ebastler/S21Evo/S21Evo_BST/S21Evo_BST.pdf

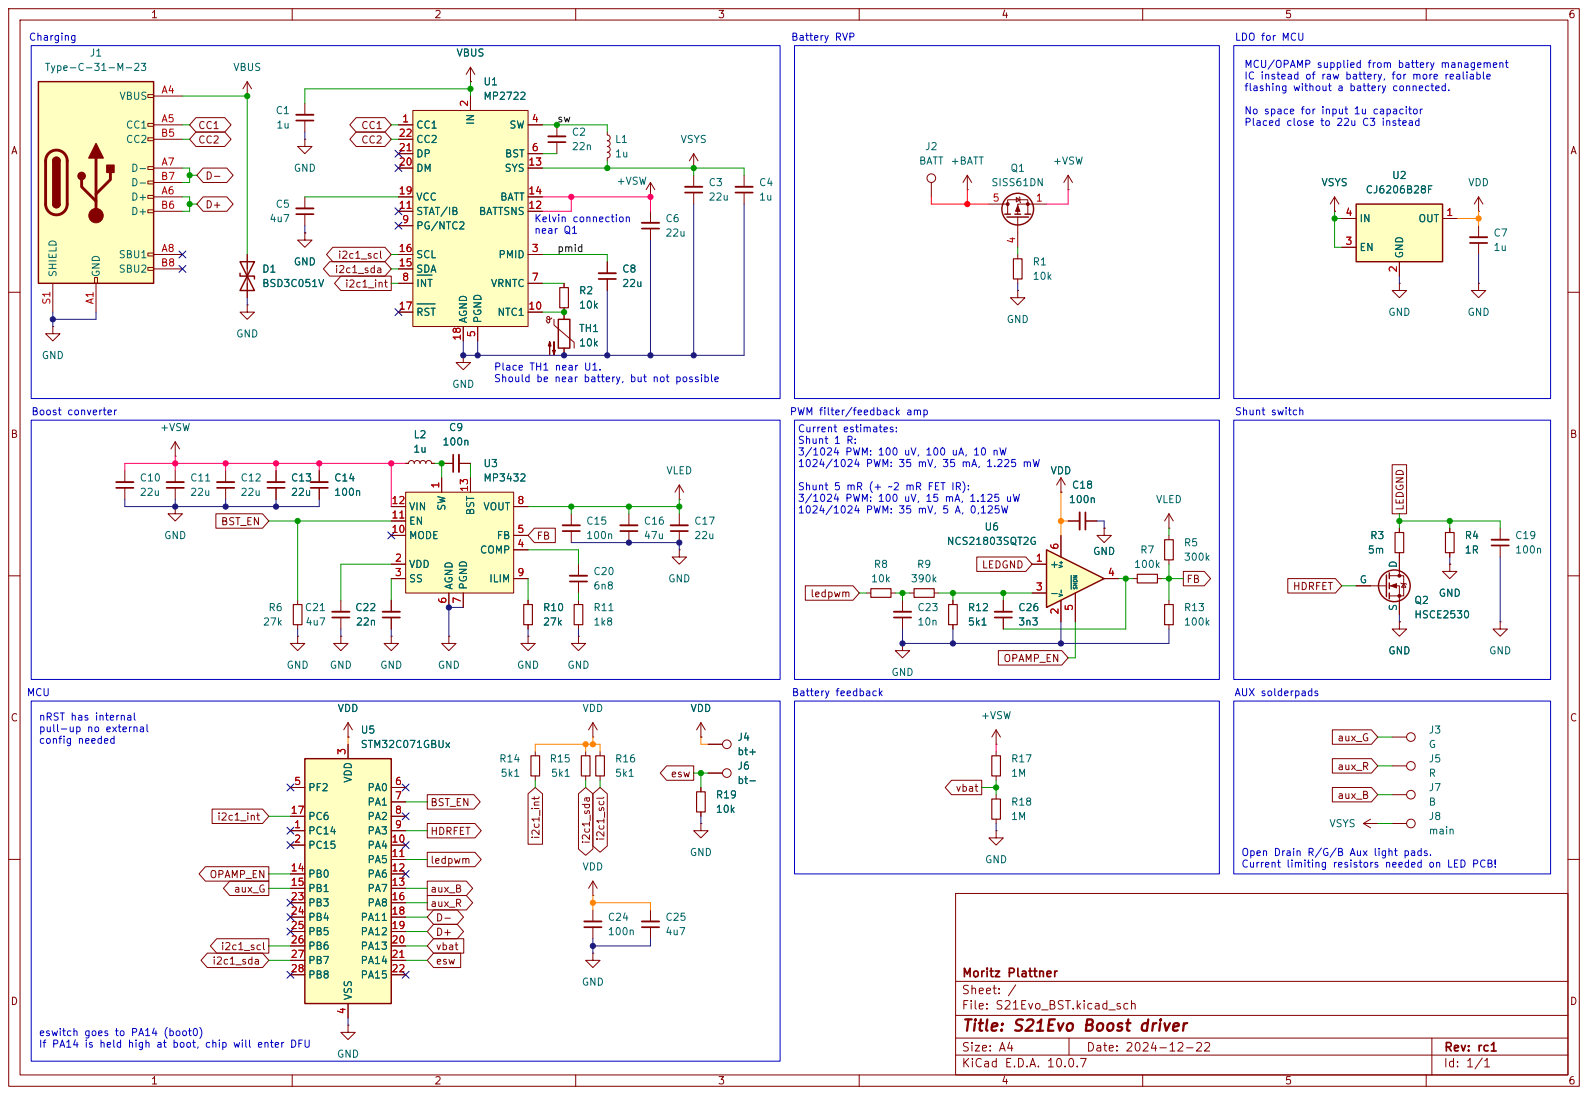
[picture p1: page 1]

LDO for MCU MCU

IC instead of raw battery, for more realiable
flashing without a battery connected. No space for input 1u capacitor Placed close to 22u C3 instead

1024/1024 PWM: 35 mV, 35 mA, 1.225 mW

Shunt 5 mR (+ ~2 mR FET IR):
3/1024 PWM: 100 uV, 15 mA, 1.125 uW
1024/1024 PWM: 35 mV, 5 A, 0,125W

eswitch goes to PA14 (boot0)
If PA14 is held high at boot, chip will enter DFU

Size: A4 | Rev: rc1
KiCad E.D.A. 10.0.7 | Id: 1/1
