ebastler/S21Evo/S21Evo_BST/S21Evo_BST.kicad_pcb

## KiCad design S21Evo_BST/S21Evo_BST.kicad_pcb (2026-10-29)

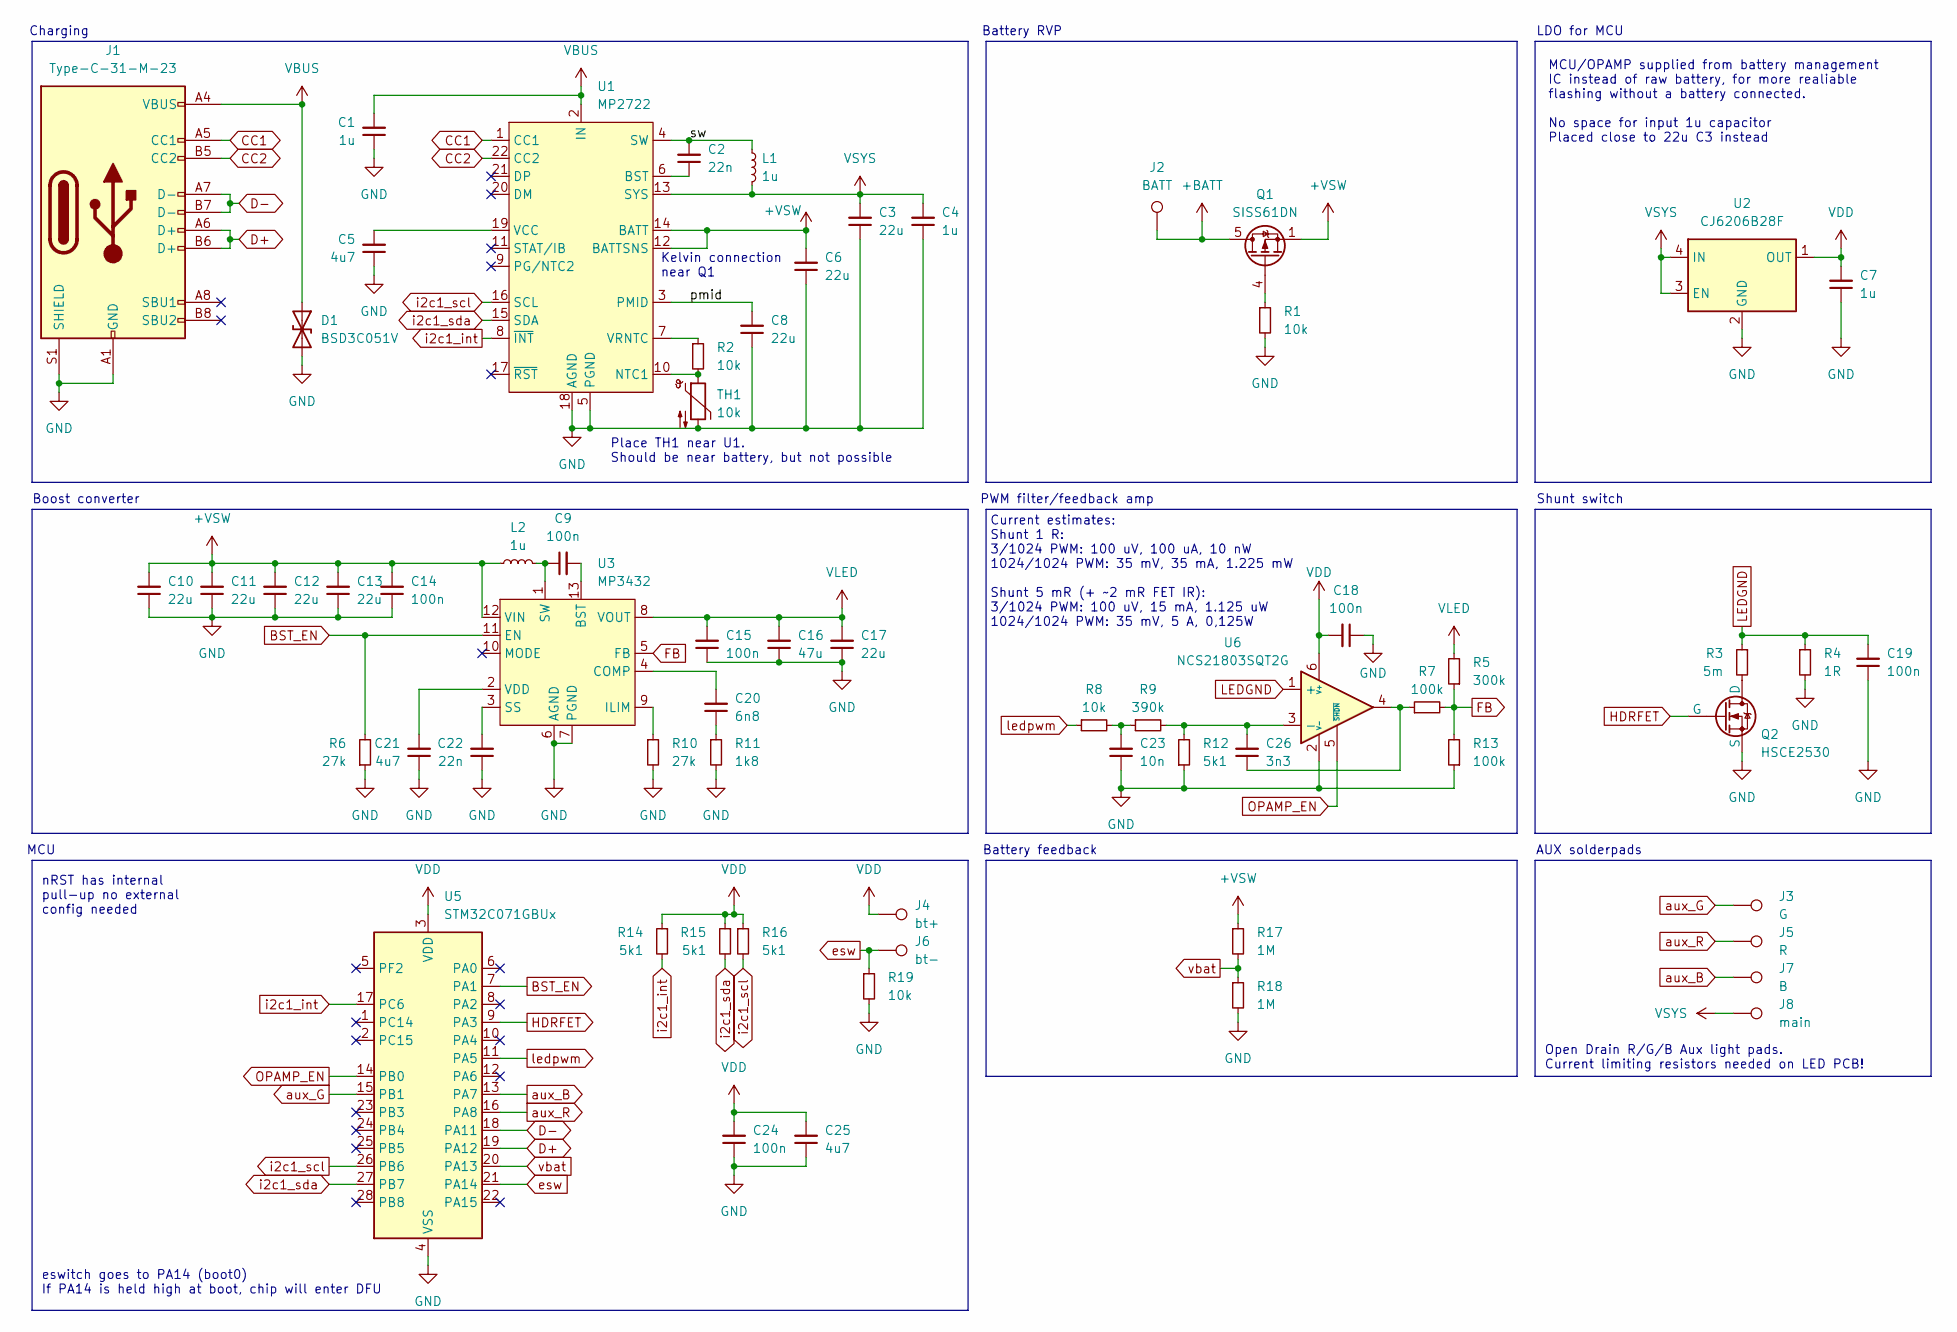
[picture p2: schematic S21Evo_BST.kicad_sch, S21Evo Boost driver]

Parts:
C1, C4, C7: 1u; C_0402_1005Metric; Part number CL05A105KA5NQNC; LCSC C52923
C2, C22: 22n; C_0402_1005Metric; Part number CL05B223KA5NNNC; LCSC C318578
C3, C6, C8, C10, C11, C13, C17: 22u; C_0603_1608Metric; Part number CL10A226MO7JZNC; LCSC C2762594
C5, C21, C25: 4u7; C_0402_1005Metric; Part number CL05A475MP5NRNC; LCSC C23733
C9, C14, C15, C18, C19, C24: 100n; C_0402_1005Metric; Part number CL05B104KB54PNC; LCSC C307331
C12: 22u; C_0805_2012Metric; Part number CL21A226MAQNNNE; LCSC C45783
C16: 47u; C_1206_3216Metric; Part number CL31A476MPHNNNE; LCSC C96123
C20: 6n8; C_0402_1005Metric; Part number CL05B682KB5NNNC; LCSC C318580
C23: 10n; C_0402_1005Metric; Part number CL05B103KB5NNNC; LCSC C15195
C26: 3n3; C_0402_1005Metric; Part number CL05B332KB5NNNC; LCSC C26404
D1: BSD3C051V; D_SOD-323; Part number BSD3C051V; LCSC C151996
J1: Type-C-31-M-23; USB_C_Receptacle_HRO_TYPE-C-31-M-23; Part number TYPE-C-31-M-23; LCSC C530613
J2: BATT; spring_6mm
J3: G; auxpad
J4: bt+; auxpad
J5: R; auxpad
J6: bt-; auxpad
J7: B; auxpad
J8: main; auxpad
L1: 1u; L_Changjiang_FTC322520S; Part number YSMC322520H-1R0MB; LCSC C46962057
L2: 1u; L_Bourns_SRP6060FA; Part number YSPIT0660A-1R0M; LCSC C18199443
Q1: SISS61DN; Vishay_PowerPAK_1212-8_Single; Part number SISS61DN-T1-GE3; LCSC C3289430
Q2: HSCE2530; Vishay_PowerPAK_1212-8_Single; Part number HSCE2530; LCSC C701041
R1, R2, R8, R19: 10k; R_0402_1005Metric; Part number 0402WGF1002TCE; LCSC C25744
R3: 5m; R_0805_2012Metric; Part number MS05W2F500NT5E; LCSC C92742
R4: 1R; R_0402_1005Metric; Part number 0402WGF100KTCE; LCSC C25086
R5: 300k; R_0402_1005Metric; Part number 0402WGF3003TCE; LCSC C25774
R6, R10: 27k; R_0402_1005Metric; Part number 0402WGF2702TCE; LCSC C25771
R7, R13: 100k; R_0402_1005Metric; Part number 0402WGF1003TCE; LCSC C25741
R9: 390k; R_0402_1005Metric; Part number 0402WGF3903TCE; LCSC C25782
R11: 1k8; R_0402_1005Metric; Part number 0402WGF1801TCE; LCSC C25871
R12, R14, R15, R16: 5k1; R_0402_1005Metric; Part number 0402WGF5101TCE; LCSC C25905
R17, R18: 1M; R_0402_1005Metric; Part number 0402WGF1004TCE; LCSC C26083
TH1: 10k; R_0402_1005Metric; Part number NTCG103JF103FT1; LCSC C209959
U1: MP2722; QFN-22_MP2722_2.5x3.5mm_P0.4mm; Part number MP2722GRH-0000-Z; LCSC C20099551
U2: CJ6206B28F; OnSemi_XDFN4-1EP_1.0x1.0mm_EP0.52x0.52mm; Part number CJ6206B28F; LCSC C2829371
U3: MP3432; QFN-13_3x4mm_P0.5mm; Part number MP3432GL-Z; LCSC C3187976
U5: STM32C071GBUx; QFN-28_4x4mm_P0.5mm; Part number STM32C071GBU6; LCSC C42113261
U6: NCS21803SQT2G; SOT-363_SC-70-6; Part number NCS21803SQT2G; LCSC C5209288

Connections:
+BATT: J2.1 (1_1), Q1.5 (D)
+VSW: C6.2, C10.2, C11.2, C12.2, C13.2, C14.2, L2.1, Q1.1 (S), Q1.2 (S), Q1.3 (S), R17.1, U1.12 (BATTSNS), U1.14 (BATT), U3.12 (VIN)
/pmid: C8.2, U1.3 (PMID)
/sw: C2.2, L1.1, U1.4 (SW)
BST_EN: R6.2, U3.11 (EN), U5.7 (PA1)
CC1: J1.A5 (CC1), U1.1 (CC1)
CC2: J1.B5 (CC2), U1.22 (CC2)
D+: J1.A6 (D+), J1.B6 (D+), U5.19 (PA12)
D-: J1.A7 (D-), J1.B7 (D-), U5.18 (PA11)
FB: R5.1, R7.2, R13.2, U3.5 (FB)
GND: C1.1, C3.1, C4.1, C5.1, C6.1, C7.1, C8.1, C10.1, C11.1, C12.1, C13.1, C14.1, C15.1, C16.1, C17.1, C18.1, C19.1, C21.1, C22.1, C23.1, C24.1, C25.1, D1.2 (A2), J1.A1 (GND), J1.A12 (GND), J1.B1 (GND), J1.B12 (GND), J1.S1 (SHIELD), Q2.1 (S), Q2.2 (S), Q2.3 (S), R1.2, R4.2, R6.1, R10.2, R11.2, R12.1, R13.1, R18.2, R19.2, TH1.2, U1.5 (PGND), U1.18 (AGND), U2.2 (GND), U2.5 (GND), U3.6 (AGND), U3.7 (PGND), U5.4 (VSS), U6.2 (V-)
HDRFET: Q2.4 (G), U5.9 (PA3)
LEDGND: C19.2, R3.1, R4.1, U6.1 (+)
unnamed: C20.1, R11.1
unnamed: C23.2, R8.2, R9.1
unnamed: C26.1, R7.1, U6.4
unnamed: Q1.4 (G), R1.1
unnamed: Q2.5 (D), Q2.6 (D), Q2.7 (D), Q2.8 (D), Q2.9 (D), R3.2
unnamed: C2.1, U1.6 (BST)
unnamed: R2.2, TH1.1, U1.10 (NTC1)
unnamed: C5.2, U1.19 (VCC)
unnamed: R2.1, U1.7 (VRNTC)
unnamed: C9.2, U3.13 (BST)
unnamed: C20.2, U3.4 (COMP)
unnamed: R10.1, U3.9 (ILIM)
unnamed: C22.2, U3.3 (SS)
unnamed: C9.1, L2.2, U3.1 (SW)
unnamed: C21.2, U3.2 (VDD)
unnamed: C26.2, R9.2, R12.2, U6.3 (-)
OPAMP_EN: U5.14 (PB0), U6.5 (~SHDN)
VBUS: C1.2, D1.1 (A1), J1.A4 (VBUS), J1.A9 (VBUS), J1.B4 (VBUS), J1.B9 (VBUS), U1.2 (IN)
VDD: C7.2, C18.2, C24.2, C25.2, J4.1 (1_1), R14.1, R15.1, R16.1, U2.1 (OUT), U5.3 (VDD), U6.6 (V+)
VLED: C15.2, C16.2, C17.2, R5.2, U3.8 (VOUT)
VSYS: C3.2, C4.2, J8.1 (1_1), L1.2, U1.13 (SYS), U2.3 (EN), U2.4 (IN)
aux_B: J7.1 (1_1), U5.13 (PA7)
aux_G: J3.1 (1_1), U5.15 (PB1)
aux_R: J5.1 (1_1), U5.16 (PA8)
esw: J6.1 (1_1), R19.1, U5.21 (PA14)
i2c1_int: R14.2, U1.8 (~INT), U5.17 (PC6)
i2c1_scl: R16.2, U1.16 (SCL), U5.26 (PB6)
i2c1_sda: R15.2, U1.15 (SDA), U5.27 (PB7)
ledpwm: R8.1, U5.11 (PA5)
vbat: R17.2, R18.1, U5.20 (PA13)

Notes on the sheet:
eswitch goes to PA14 (boot0) If PA14 is held high at boot, chip will enter DFU
nRST has internal pull-up no external config needed
Place TH1 near U1. Should be near battery, but not possible
MCU/OPAMP supplied from battery management IC instead of raw battery, for more realiable flashing without a battery connected. No space for input 1u capacitor Placed close to 22u C3 instead
LDO for MCU
Battery feedback
PWM filter/feedback amp
Battery RVP
Shunt switch
Current estimates: Shunt 1 R: 3/1024 PWM: 100 uV, 100 uA, 10 nW 1024/1024 PWM: 35 mV, 35 mA, 1.225 mW Shunt 5 mR (+ ~2 mR FET IR): 3/1024 PWM: 100 uV, 15 mA, 1.125 uW 1024/1024 PWM: 35 mV, 5 A, 0,125W
Charging
MCU
AUX solderpads
Boost converter
Open Drain R/G/B Aux light pads. Current limiting resistors needed on LED PCB!
Kelvin connection near Q1

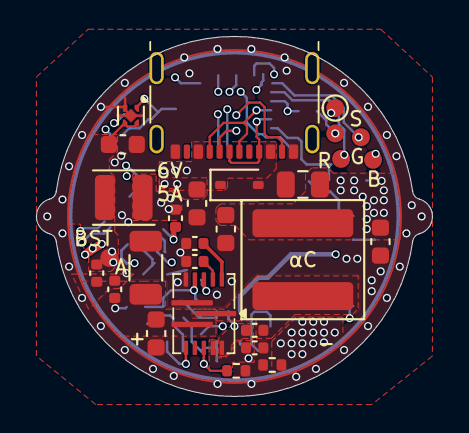
[picture p3: board S21Evo_BST.kicad_pcb from above]

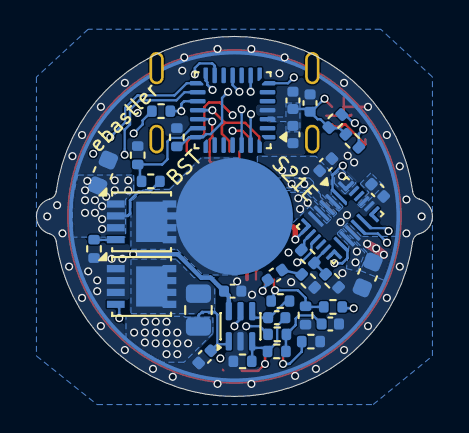
[picture p4: board S21Evo_BST.kicad_pcb from below]

Board: 4 copper layers, 22.0 x 20.0 mm, 64 parts (36 on the bottom side), 43 nets.
