ebastler/S21Evo/S21Evo_ESW/S21Evo_ESW.kicad_pcb

## KiCad design S21Evo_ESW/S21Evo_ESW.kicad_pcb (2026-10-29)

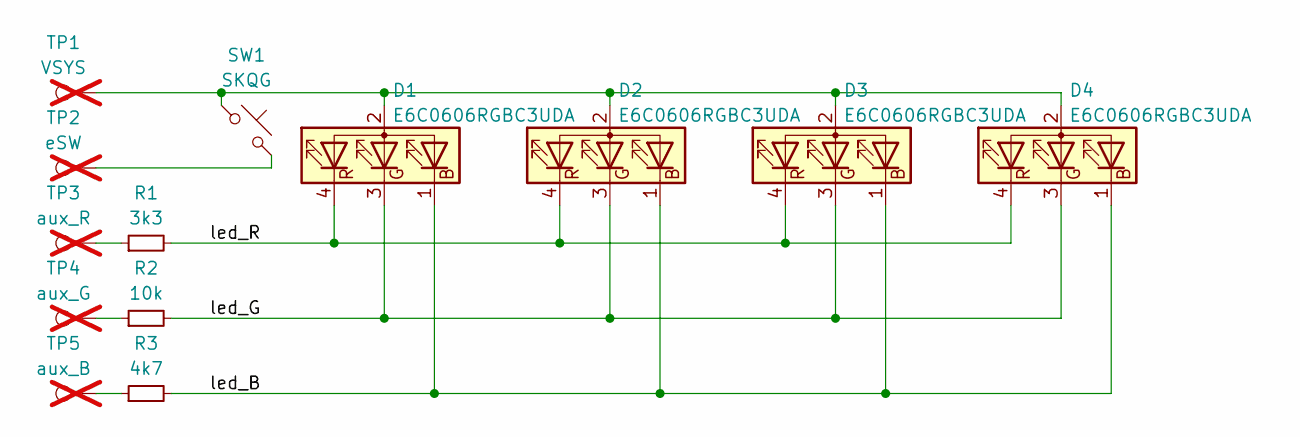
[picture p5: schematic S21Evo_ESW.kicad_sch]

Parts:
D1, D2, D3, D4: E6C0606RGBC3UDA; LED_1616; Part number E6C0606RGBC3UDA; LCSC C375569
R1: 3k3; R_0402_1005Metric; Part number 0402WGF3301TCE; LCSC C25890
R2: 10k; R_0402_1005Metric; Part number 0402WGF1002TCE; LCSC C25744
R3: 4k7; R_0402_1005Metric; Part number 0402WGF4701TCE; LCSC C25900
SW1: SKQG; SW_SPST_SKQG_WithStem; Part number SKQGABE010; LCSC C115351
TP1: VSYS; auxpad; not fitted
TP2: eSW; auxpad; not fitted
TP3: aux_R; auxpad; not fitted
TP4: aux_G; auxpad; not fitted
TP5: aux_B; auxpad; not fitted

Connections:
/led_B: D1.1 (BK), D2.1 (BK), D3.1 (BK), D4.1 (BK), R3.2
/led_G: D1.3 (GK), D2.3 (GK), D3.3 (GK), D4.3 (GK), R2.2
/led_R: D1.4 (RK), D2.4 (RK), D3.4 (RK), D4.4 (RK), R1.2
unnamed: D1.2 (A), D2.2 (A), D3.2 (A), D4.2 (A), SW1.1, TP1.1
unnamed: R1.1, TP3.1
unnamed: R2.1, TP4.1
unnamed: R3.1, TP5.1
unnamed: SW1.2, TP2.1

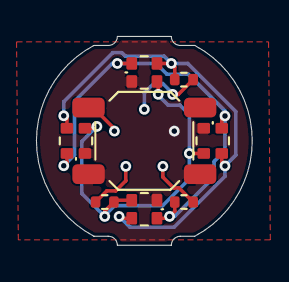
[picture p6: board S21Evo_ESW.kicad_pcb from above]

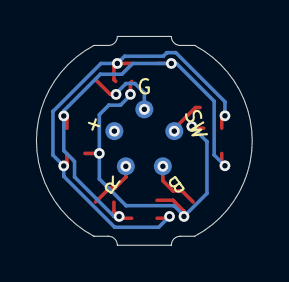
[picture p7: board S21Evo_ESW.kicad_pcb from below]

Board: 2 copper layers, 12.0 x 11.6 mm, 13 parts (5 on the bottom side), 8 nets.
